B37Z0/UNO-Q/CNN exploration/test_image.jpg

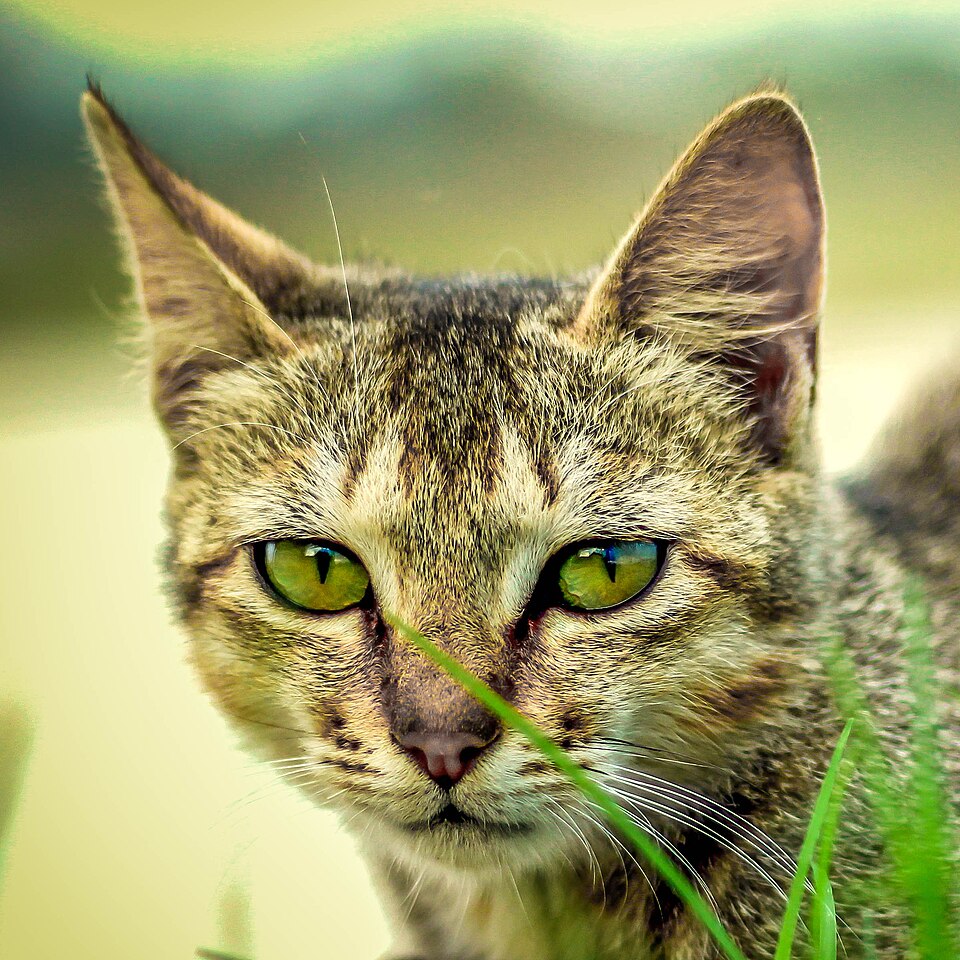
CNN exploration/test_image.jpg
