B37Z0/UNO-Q/CV exploration/Edge Impulse/person_test.jpg

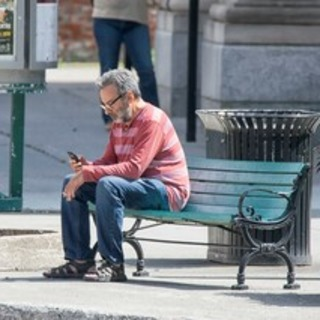
CV exploration/Edge Impulse/person_test.jpg
